fabPlane/viagrid_fp/ykush/README.md

# YKUSH-VG: 3-port switchable USB 2.0 hub on a Viagrid 9055 blank

A board that works like the [Yepkit YKUSH](https://www.yepkit.com/products/ykush), laid out for a
2-layer [Viagrid](https://github.com/opulo-inc/viagrid) 9055 blank.

- **Hub:** Terminus FE1.1s (SSOP-28). Upstream port is USB-C. Ports 1-3 go to the USB-A sockets,
  and port 4 goes to the control MCU.
- **Control:** WCH CH552G. The host sees it as a HID device. The plan is for its firmware to speak
  the YKUSH protocol, so `ykushcmd` works unchanged.
- **Port power:** one SY6280AAC current-limited switch per port. The CH552G drives each EN pin,
  and each EN has a 100k pull-down so the port stays off during boot.
- **Power:** from upstream VBUS, or from an external 5 V screw terminal. The two sources are
  diode-ORed onto `+5V_PORT`.

| File | What |
|---|---|
| `FEASIBILITY.md` | Why this is doable on Viagrid, and the risks |
| `kicad/ykush_vg.kicad_pro` / `.kicad_sch` | KiCad 10 project and schematic (generated) |
| `kicad/ykush_vg.kicad_sym`, `kicad/sym-lib-table` | Project symbol library (CH552G, SY6280AAC) |
| `kicad/ykush_vg_schematic.pdf` | PDF of the schematic |
| `kicad/bom.md`, `kicad/bom.csv` | BOM with Shopee/Lazada, AliExpress, DigiKey and JLCPCB columns |
| `kicad/nets.txt` | Netlist the generator intended |
| `tools/make_schematic.py` | **Source of truth.** Edit this, then regenerate |
| `tools/check_netlist.py` | Exports the netlist with kicad-cli and diffs it against `nets.txt` |
| `kicad/ykush_vg.kicad_pcb` | The PCB, generated by `tools/build_pcb.py` (see `pcb/LAYOUT.md`) |
| `firmware/` | CH552G firmware (SDCC), tests, host tool, udev rule |
| `fab/` | Laser DXFs, Gerbers, drill file, `holes_to_drill.csv`, placement file, previews |

```sh
cd tools && python3 make_schematic.py && python3 check_netlist.py
kicad-cli sch erc --severity-all ../kicad/ykush_vg.kicad_sch
```

Needs KiCad 10. The generator reads the KiCad 10 symbol libraries and then runs
`kicad-cli sch upgrade`, so the saved file is in KiCad's native format.

## Status
- [x] Schematic. Pinouts checked against the FE1.1s, CH552 and SY6280 datasheets, and against
  open-source boards.
- [x] BOM and sourcing
- [x] ERC in KiCad 10.0.6: 0 violations (all severities)
- [x] PCB layout on the Viagrid 9055 blank: fully routed. KiCad 10 DRC reports 0 errors,
  0 unconnected items and 0 schematic mismatches (details in `pcb/LAYOUT.md`).
- [x] Fabrication outputs in `fab/`: copper DXF for LightBurn, Gerbers, and the holes to drill
- [x] CH552 firmware (`firmware/`): YKUSH protocol with YKUSH USB IDs, so `ykushcmd` works.
  It builds to about 2.5 KB and passes descriptor, unit and `ykushcmd` end-to-end tests. It has not
  yet run on real hardware.
- [ ] Build and test a real board

## CH552G pin map (for the firmware)

| Function | CH552G pin |
|---|---|
| USB D+ / D- (hub port 4, Full-Speed) | P3.6 / P3.7 |
| EN port 1 (J2, left) | P1.4 |
| EN port 2 (J3, middle) | P3.3 |
| EN port 3 (J4, right) | P3.4 |
| Status LED (active high) | P3.2 |
| BOOT button (UDP pull-up at power-on) | P3.6 via 10k |

The EN pins are active high. Each has a 100k pull-down, so the ports stay off until the
firmware drives them.
