fabPlane/viagrid_fp/ykush/fab/preview_bottom.png

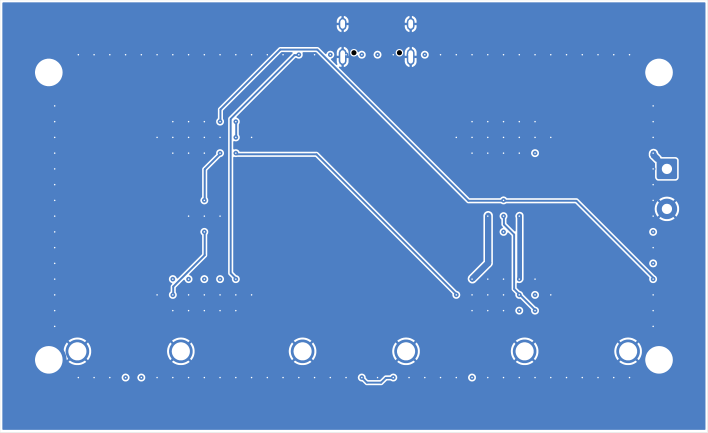
ykush/fab/preview_bottom.png
