fabPlane/viagrid_fp/ykush/fab/preview_top.png

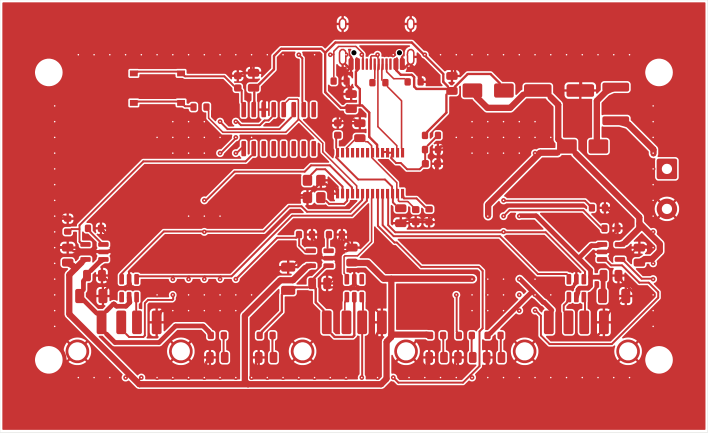
ykush/fab/preview_top.png
