fabPlane/viagrid_fp/ykush/kicad/bom.md

# YKUSH-VG bill of materials

Generated by `tools/make_schematic.py` + `tools/bom.py`. Sourcing checked 2026-09-24 from search listings; confirm price and stock before ordering.

- **25 BOM lines**, 62 parts in total.
- **Shopee/Lazada Thailand:** 18 lines seen listed, 1 likely (commodity, no exact listing seen), 6 not found in Thailand (AliExpress/LCSC instead). Many IC listings are cross-border sellers: allow 1-2 weeks.
- **JLCPCB:** 14 lines are Basic parts, 9 are Extended (about $3 setup fee each for assembly).
- **DigiKey:** does not carry the Chinese ICs (FE1.1s, CH552G, SY6280AAC); alternatives are listed but change the circuit.

| # | Refs | Qty | Part | Footprint | Shopee / Lazada (Thailand) | AliExpress | DigiKey | JLCPCB (LCSC #) | JLC type | Notes |
|---|---|---|---|---|---|---|---|---|---|---|
| 1 | U1 | 1 | Terminus FE1.1S-BSOP28 (USB 2.0 HS 4-port hub) | SSOP-28_3.9x9.9mm_P0.635mm | YES - Shopee TH (5 pcs) | YES | NO (alt: Microchip USB2514B-AEZC-TR, QFN-36) | C9359 | Extended | Buy genuine Rev B (FE1.1S-BSOP28). Cross-border seller: 1-2 weeks. |
| 2 | U2 | 1 | WCH CH552G (SOP-16 MCU, USB device) | SOIC-16_3.9x9.9mm_P1.27mm | YES - Shopee TH (variant in WCH multi-chip listing) | YES | NO (alt: PIC16F1455-I/SL; needs different firmware) | C111292 | Extended | Blank chips boot into the USB bootloader. |
| 3 | U3 U5 U7 | 3 | Silergy SY6280AAC load switch | SOT-23-5 | NO (MT9700 is on Shopee TH; verify pinout before substituting) | YES | NO (alt: TI TPS2051BDBVR, different pinout) | C55136 | Extended | Order from AliExpress/LCSC. Not SY6280AAAC (C207620). |
| 4 | U4 U6 U8 | 3 | ST USBLC6-2SC6 USB ESD array | SOT-23-6 | YES - Shopee TH, Lazada TH | YES | 497-5235-1-ND | C7519 | Extended |  |
| 5 | Y1 | 1 | YXC X322512MSB4SI 12 MHz 3225 4-pad | Crystal_SMD_3225-4Pin_3.2x2.5mm | NO (only HC-49 seen) | YES | Abracon ABM8-12.000MHZ-B2-T (535-9826-1-ND) | C9002 | Basic | Passive crystal, not an oscillator. FE1.1s has internal load caps. |
| 6 | J1 | 1 | HRO TYPE-C-31-M-12 (USB 2.0 16-pin) | USB_C_Receptacle_HRO_TYPE-C-31-M-12 | YES - Shopee TH (TYPE-C-31-M-12), Lazada TH (16P) | YES | NO (alt: GCT USB4105-GF-A, 2073-USB4105-GF-ACT-ND) | C165948 | Extended | Shell pegs need drilled holes on a Viagrid. |
| 7 | J2 J3 J4 | 3 | TE 292303-7 USB-A receptacle, right angle, SMT signal pins | USB_A_TE_292303-7_Horizontal | NO (TH has generic THT 4-pin 90deg; different footprint) | LIKELY | TE 292303-7 | (search LCSC) | Extended | SMT signal pads keep the Viagrid build simple; only the 2 shell tabs need holes. |
| 8 | J5 | 1 | Screw terminal 2P 5.08 mm (KF301-2P) | TerminalBlock_Phoenix_MKDS-1,5-2-5.08_1x02_P5.08mm_Horizontal | YES - Shopee TH, Lazada TH, Cybertice, MyArduino | YES | Phoenix 1935161 (277-1667-ND) | C474881 | Extended | THT: drill 2 holes, solder from the bottom. |
| 9 | SW1 | 1 | Tactile switch 5.1x5.1 mm SMD (XKB TS-1187A-B-A-B) | SW_Push_1P1T_XKB_TS-1187A | NO (only 3x4 / 4.5x4.5 / 6x6 seen) | YES | C&K PTS810 SJM 250 SMTR LFS | C318884 | Basic | Hold while plugging in = CH552 bootloader. |
| 10 | F1 | 1 | PTC resettable fuse 1812, 2 A hold | Fuse_1812_4532Metric | YES - Shopee TH (PPTC kit incl. 1812) | YES | Littelfuse 1812L200/12DR | C315901 | Extended |  |
| 11 | D1 D2 | 2 | SS34 Schottky 3 A 40 V, SMA | D_SMA | YES - Shopee TH (ships from Thailand) | YES | Vishay SSA34-E3/61T | C8678 | Basic |  |
| 12 | D3 D4 D5 D6 D7 | 5 | LED green 0805 | LED_0805_2012Metric | YES - Shopee TH, Lazada TH (0805 colour kits) | YES | Lite-On LTST-C171GKT | C2297 | Basic |  |
| 13 | C1 C3 C4 C6 C9 C11 C13 C14 C16 C17 C19 | 11 | MLCC 10 uF 25 V X5R 0805 | C_0805_2012Metric | YES - Lazada TH (0805 kit) | YES | Samsung CL21A106KAYNNNC | C15850 | Basic |  |
| 14 | C2 | 1 | Alu electrolytic 220 uF 10 V SMD 6.3x7.7 mm | CP_Elec_6.3x7.7 | YES - Shopee TH (220u/16V 6.3x7.7), Lazada TH | YES | Panasonic EEE-FK1A221P (verify) | (pick on LCSC) | Extended | Bulk on +5V_PORT. |
| 15 | C5 C7 C8 C10 | 4 | MLCC 100 nF 50 V X7R 0603 | C_0603_1608Metric | YES - Shopee TH (0603 kit) | YES | Yageo CC0603KRX7R9BB104 | C14663 | Basic |  |
| 16 | C12 C15 C18 | 3 | MLCC 22 uF 25 V X5R 1206 | C_1206_3216Metric | LIKELY | YES | Samsung CL31A226KAHNNNE | C12891 | Basic | Per-port bulk. USB 2.0 asks for 120 uF per port; SY6280 soft-start limits inrush instead. |
| 17 | R1 R2 | 2 | Resistor 5.1 k 1% 0603 | R_0603_1608Metric | YES - Shopee TH (0603 kit, 33 values x 20) | YES | generic | C23186 | Basic | USB-C CC |
| 18 | R3 R8 R11 R14 R17 | 5 | Resistor 1 k 1% 0603 | R_0603_1608Metric | YES - Shopee TH (0603 kit, 33 values x 20) | YES | generic | C21190 | Basic |  |
| 19 | R4 | 1 | Resistor 2.7 k 1% 0603 (FE1.1s REXT) | R_0603_1608Metric | YES - Shopee TH (0603 kit, 33 values x 20) | YES | generic | C13167 | Basic | Must be 1%. |
| 20 | R5 | 1 | Resistor 56 k 1% 0603 | R_0603_1608Metric | YES - Shopee TH (0603 kit, 33 values x 20) | YES | generic | C23206 | Basic | VBUSM divider top (also drives XRSTJ/BUSJ). |
| 21 | R6 R10 R13 R16 | 4 | Resistor 100 k 1% 0603 | R_0603_1608Metric | YES - Shopee TH (0603 kit, 33 values x 20) | YES | generic | C25803 | Basic |  |
| 22 | R7 R9 R12 R15 | 4 | Resistor 10 k 1% 0603 | R_0603_1608Metric | YES - Shopee TH (0603 kit, 33 values x 20) | YES | generic | C25804 | Basic | ISET: 10k = ~0.68 A limit; 6.8k (C23212) = ~1 A. |
| 23 | JP1 | 1 | Resistor 0 R 0603 (jumper over USB-C D+ trace) | R_0603_1608Metric | YES - Shopee TH (0603 kit, 33 values x 20) | YES | generic | C21189 | Basic | Board jumper: USB-C data pads are interleaved. |
| 24 | - | 1 | Viagrid 9055 Standard blank (90x55 mm, 2-layer, ENIG) | - | NO | NO | NO | - | - | Opulo (opulo.io), or have JLCPCB/PCBWay make it from the open-source Viagrid files. |
| 25 | - | 1 | Enclosure Hammond 1591XXB (optional) | - | NO (generic ABS boxes only) | LIKELY (clones) | HM1038-ND (1591XXBBK) | - | - | TME Thailand lists Hammond (ships from abroad). |
