fabPlane/viagrid_fp/ykush/fab/copper_top.dxf

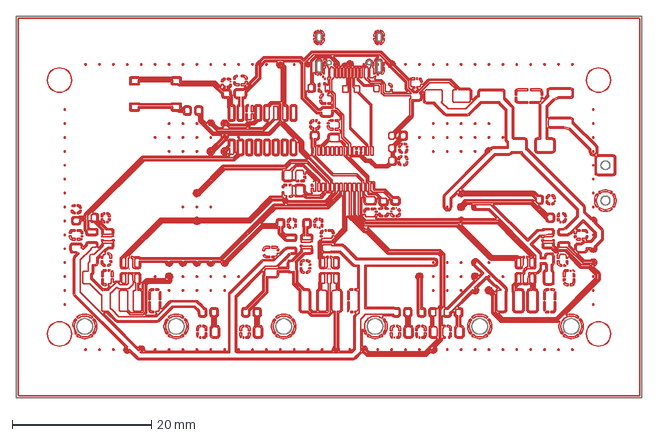
[picture p3: CAD file, 2026-09-24]
ykush/fab/copper_top.dxf
89.9 x 54.9 mm
