fabPlane/viagrid_fp/ykush/fab/copper_bottom.dxf

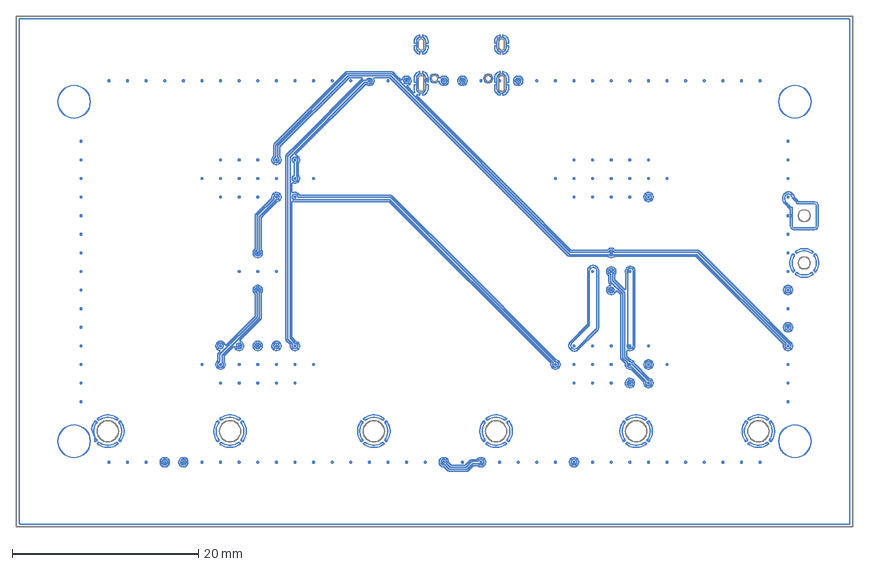
[picture p4: CAD file, 2026-09-24]
ykush/fab/copper_bottom.dxf
89.9 x 54.9 mm
