fabPlane/viagrid_fp/ykush/kicad/ykush_vg_schematic.pdf

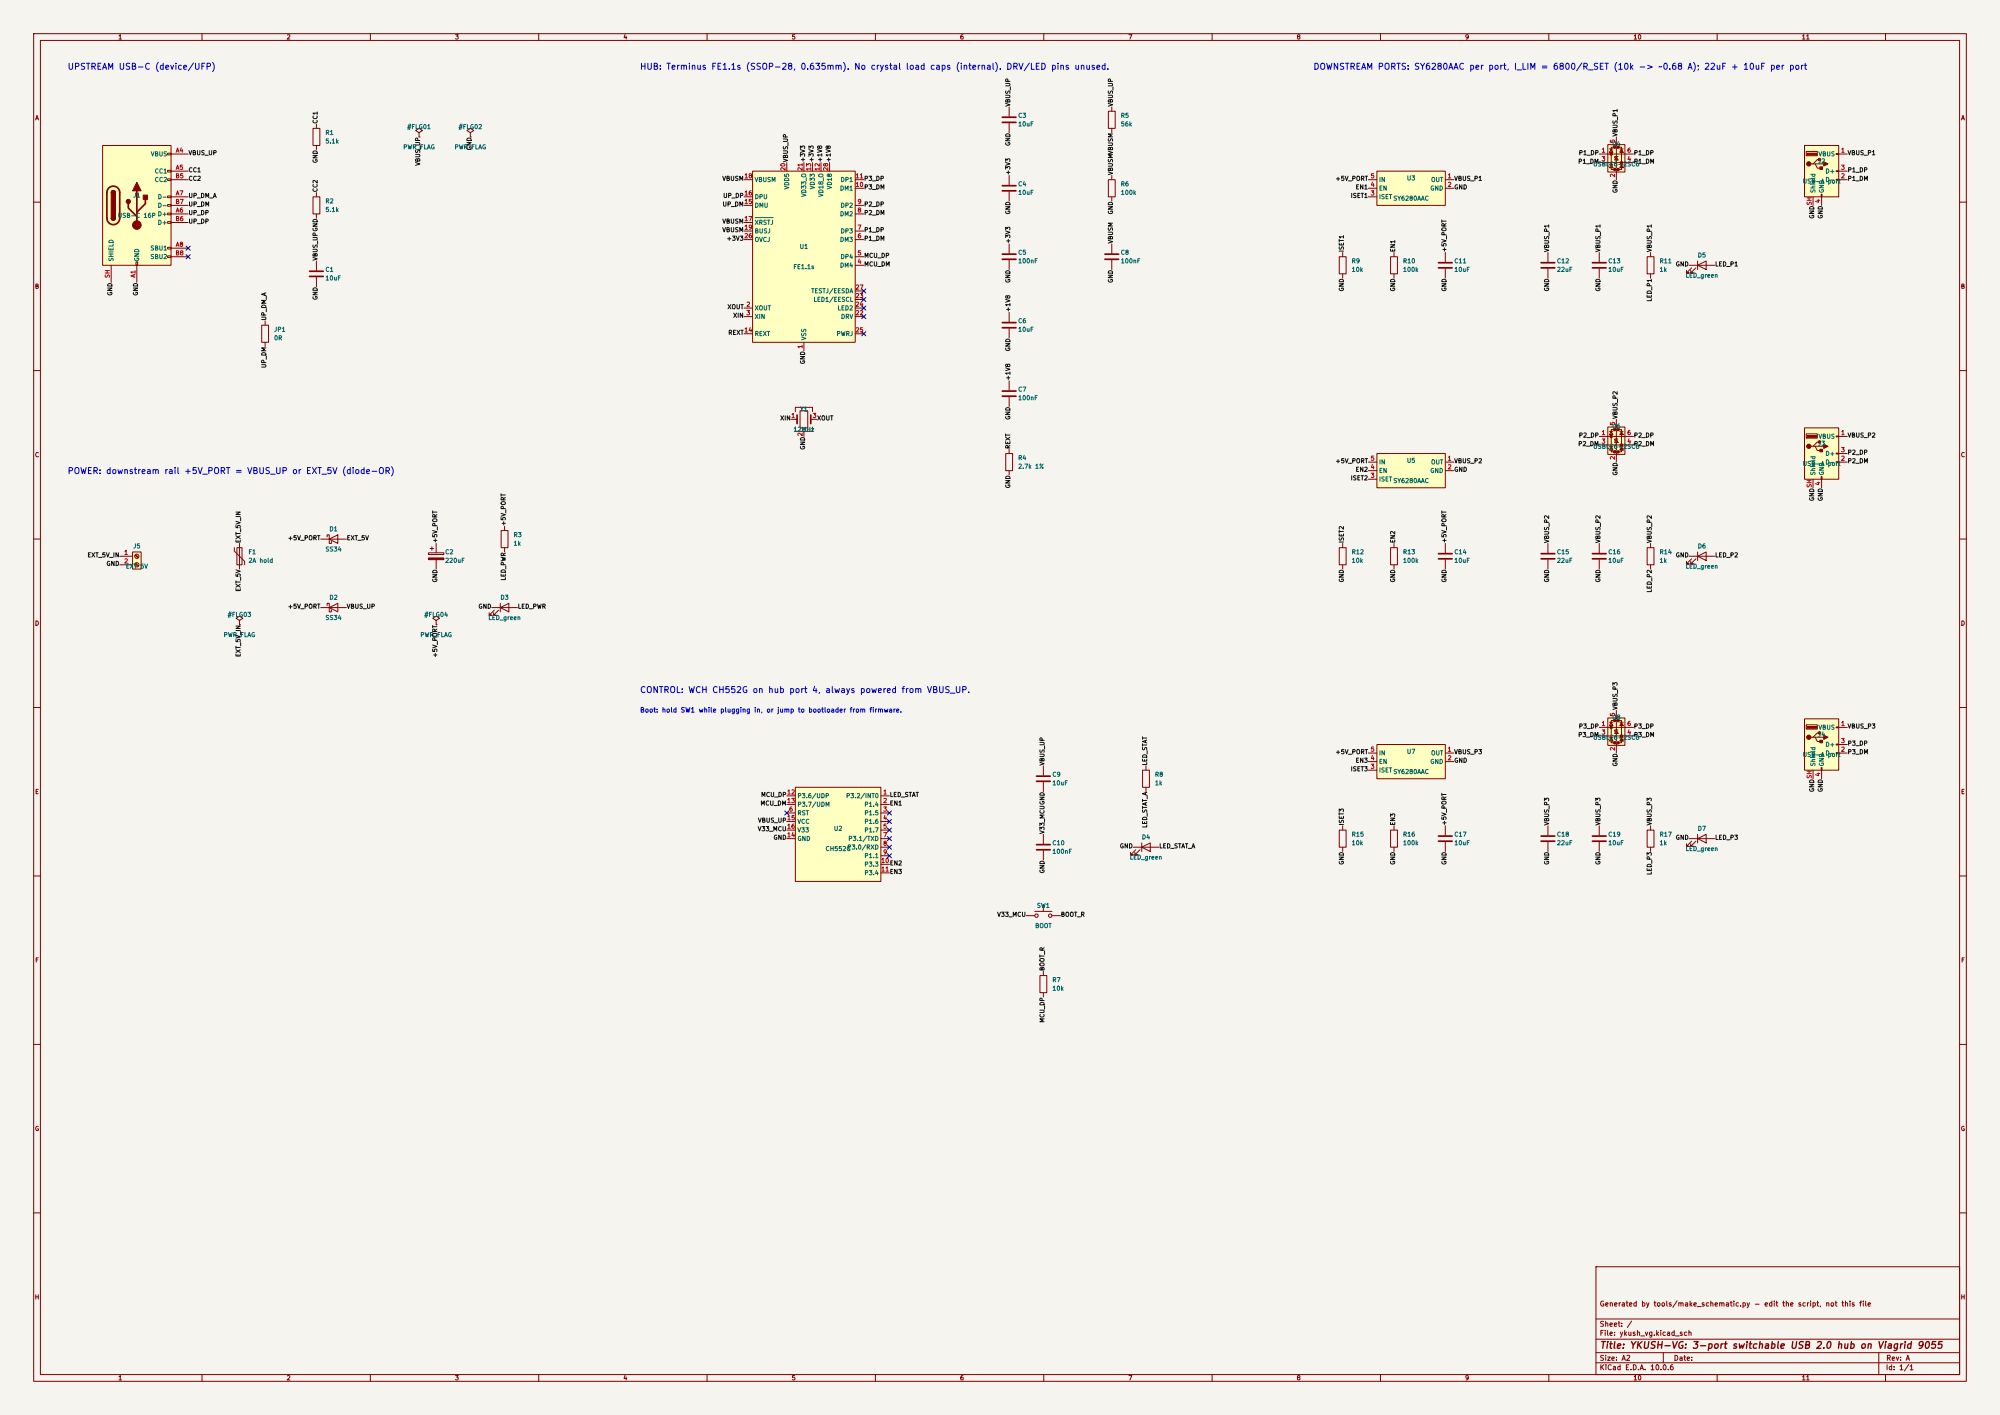
[picture p5: page 1]

HUB: Terminus FE1.1s (SSOP-28, 0.635mm). No crystal load caps (internal). DRV/LED pins unused.
TESTJ/EESDA 27 VD18 28 U1

POWER: downstream rail +5V_PORT = VBUS_UP or EXT_5V (diode-OR)

Boot: hold SW1 while plugging in, or jump to bootloader from firmware. CONTROL: WCH CH552G on hub port 4, always powered from VBUS_UP.

Generated by tools/make_schematic.py - edit the script, not this file

Sheet: /
File: ykush_vg.kicad_sch
Title: YKUSH-VG: 3-port switchable USB 2.0 hub on Viagrid 9055

Size: A2 | Rev: A
KiCad E.D.A. 10.0.6 | Id: 1/1
