fabPlane/viagrid_fp/ykush/kicad/ykush_vg.kicad_pcb

## KiCad design ykush/kicad/ykush_vg.kicad_pcb (2026-09-24)

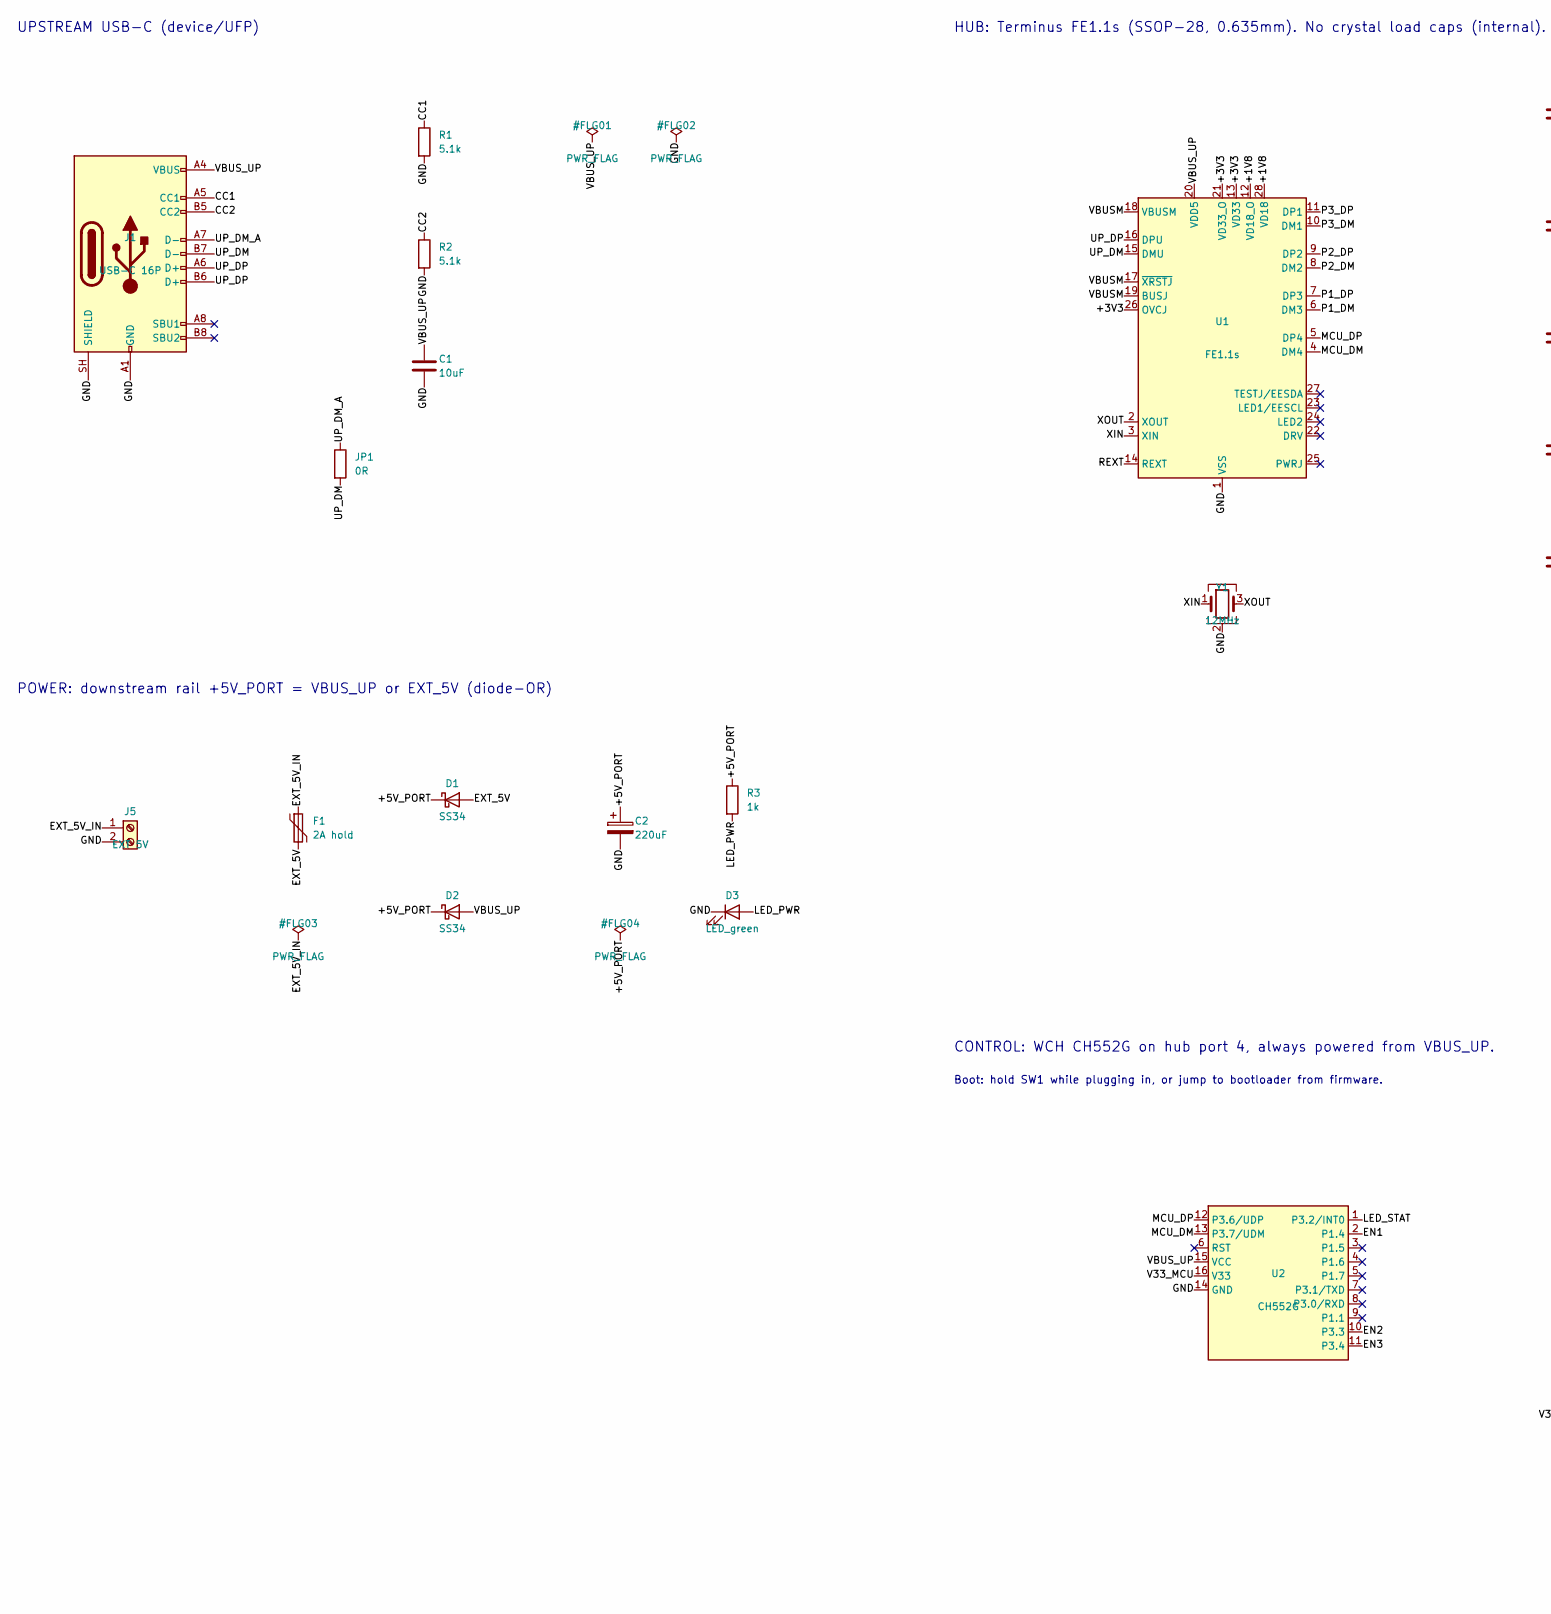
[picture p6: schematic ykush_vg.kicad_sch, YKUSH-VG: 3-port switchable USB 2.0 hub on Viagrid 9055, part in row 1, column 1]

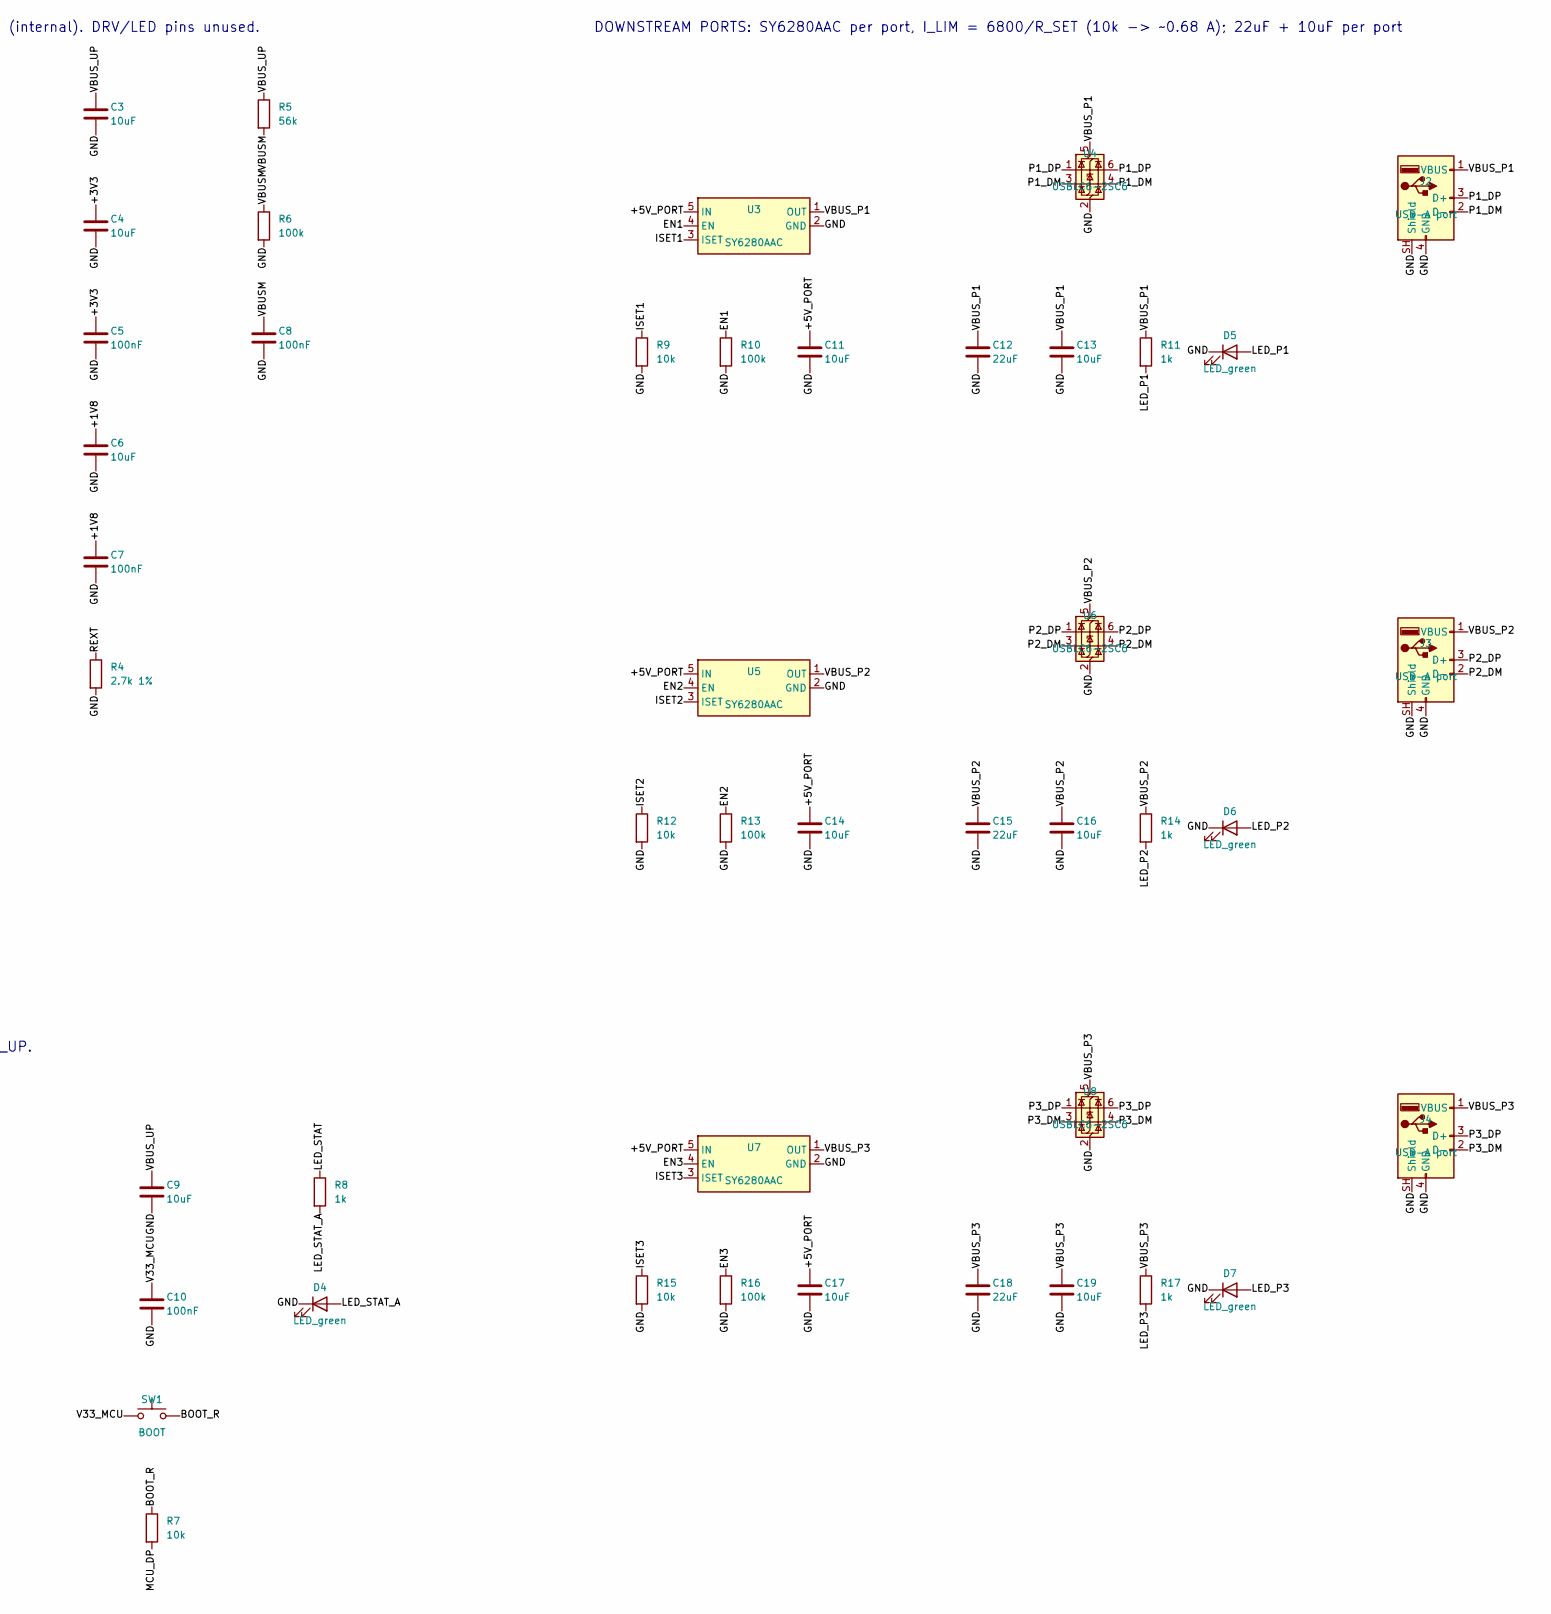
[picture p7: schematic ykush_vg.kicad_sch, YKUSH-VG: 3-port switchable USB 2.0 hub on Viagrid 9055, part in row 1, column 2]

Parts:
C1, C3, C4, C6, C9, C11, C13, C14, C16, C17, C19: 10uF; C_0805_2012Metric
C2: 220uF; CP_Elec_6.3x7.7
C5, C7, C8, C10: 100nF; C_0603_1608Metric
C12, C15, C18: 22uF; C_1206_3216Metric
D1, D2: SS34; D_SMA
D3, D4, D5, D6, D7: LED_green; LED_0805_2012Metric
F1: 2A hold; Fuse_1812_4532Metric
J1: USB-C 16P; USB_C_Receptacle_HRO_TYPE-C-31-M-12
J2, J3, J4: USB-A port; USB_A_TE_292303-7_Horizontal
J5: EXT 5V; TerminalBlock_Phoenix_MKDS-1,5-2-5.08_1x02_P5.08mm_Horizont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
JP1: 0R; R_0603_1608Metric
R1, R2: 5.1k; R_0603_1608Metric
R3, R8, R11, R14, R17: 1k; R_0603_1608Metric
R4: 2.7k 1%; R_0603_1608Metric
R5: 56k; R_0603_1608Metric
R6, R10, R13, R16: 100k; R_0603_1608Metric
R7, R9, R12, R15: 10k; R_0603_1608Metric
SW1: BOOT; SW_Push_1P1T_XKB_TS-1187A
U1: FE1.1s; SSOP-28_3.9x9.9mm_P0.635mm
U2: CH552G; SOIC-16_3.9x9.9mm_P1.27mm
U3, U5, U7: SY6280AAC; SOT-23-5
U4, U6, U8: USBLC6-2SC6; SOT-23-6
Y1: 12MHz; Crystal_SMD_3225-4Pin_3.2x2.5mm

Connections:
/+1V8: C6.1, C7.1, U1.12 (VD18_O), U1.28 (VD18)
/+3V3: C4.1, C5.1, U1.13 (VD33), U1.21 (VD33_O), U1.26 (OVCJ)
/+5V_PORT: C2.1, C11.1, C14.1, C17.1, D1.1 (K), D2.1 (K), R3.1, U3.5 (IN), U5.5 (IN), U7.5 (IN)
/BOOT_R: R7.1, SW1.2
/CC1: J1.A5 (CC1), R1.1
/CC2: J1.B5 (CC2), R2.1
/EN1: R10.1, U2.2 (P1.4), U3.4 (EN)
/EN2: R13.1, U2.10 (P3.3), U5.4 (EN)
/EN3: R16.1, U2.11 (P3.4), U7.4 (EN)
/EXT_5V: D1.2 (A), F1.2
/EXT_5V_IN: F1.1, J5.1
/GND: C1.2, C2.2, C3.2, C4.2, C5.2, C6.2, C7.2, C8.2, C9.2, C10.2, C11.2, C12.2, C13.2, C14.2, C15.2, C16.2, C17.2, C18.2, C19.2, D3.1 (K), D4.1 (K), D5.1 (K), D6.1 (K), D7.1 (K), J1.A1 (GND), J1.A12 (GND), J1.B1 (GND), J1.B12 (GND), J1.SH (SHIELD), J2.4 (GND), J2.SH (Shield), J3.4 (GND), J3.SH (Shield), J4.4 (GND), J4.SH (Shield), J5.2, R1.2, R2.2, R4.2, R6.2, R9.2, R10.2, R12.2, R13.2, R15.2, R16.2, U1.1 (VSS), U2.14 (GND), U3.2 (GND), U4.2 (GND), U5.2 (GND), U6.2 (GND), U7.2 (GND), U8.2 (GND), Y1.2 (G), Y1.4 (G)
/ISET1: R9.1, U3.3 (ISET)
/ISET2: R12.1, U5.3 (ISET)
/ISET3: R15.1, U7.3 (ISET)
/LED_P1: D5.2 (A), R11.2
/LED_P2: D6.2 (A), R14.2
/LED_P3: D7.2 (A), R17.2
/LED_PWR: D3.2 (A), R3.2
/LED_STAT: R8.1, U2.1 (P3.2/INT0)
/LED_STAT_A: D4.2 (A), R8.2
/MCU_DM: U1.4 (DM4), U2.13 (P3.7/UDM)
/MCU_DP: R7.2, U1.5 (DP4), U2.12 (P3.6/UDP)
/P1_DM: J2.2 (D-), U1.6 (DM3), U4.3 (I/O2), U4.4 (I/O2)
/P1_DP: J2.3 (D+), U1.7 (DP3), U4.1 (I/O1), U4.6 (I/O1)
/P2_DM: J3.2 (D-), U1.8 (DM2), U6.3 (I/O2), U6.4 (I/O2)
/P2_DP: J3.3 (D+), U1.9 (DP2), U6.1 (I/O1), U6.6 (I/O1)
/P3_DM: J4.2 (D-), U1.10 (DM1), U8.3 (I/O2), U8.4 (I/O2)
/P3_DP: J4.3 (D+), U1.11 (DP1), U8.1 (I/O1), U8.6 (I/O1)
/REXT: R4.1, U1.14 (REXT)
/UP_DM: J1.B7 (D-), JP1.2, U1.15 (DMU)
/UP_DM_A: J1.A7 (D-), JP1.1
/UP_DP: J1.A6 (D+), J1.B6 (D+), U1.16 (DPU)
/V33_MCU: C10.1, SW1.1, U2.16 (V33)
/VBUSM: C8.1, R5.2, R6.1, U1.17 (~XRSTJ), U1.18 (VBUSM), U1.19 (BUSJ)
/VBUS_P1: C12.1, C13.1, J2.1 (VBUS), R11.1, U3.1 (OUT), U4.5 (VBUS)
/VBUS_P2: C15.1, C16.1, J3.1 (VBUS), R14.1, U5.1 (OUT), U6.5 (VBUS)
/VBUS_P3: C18.1, C19.1, J4.1 (VBUS), R17.1, U7.1 (OUT), U8.5 (VBUS)
/VBUS_UP: C1.1, C3.1, C9.1, D2.2 (A), J1.A4 (VBUS), J1.A9 (VBUS), J1.B4 (VBUS), J1.B9 (VBUS), R5.1, U1.20 (VDD5), U2.15 (VCC)
/XIN: U1.3 (XIN), Y1.1
/XOUT: U1.2 (XOUT), Y1.3

Notes on the sheet:
HUB: Terminus FE1.1s (SSOP-28, 0.635mm). No crystal load caps (internal). DRV/LED pins unused.
UPSTREAM USB-C (device/UFP)
POWER: downstream rail +5V_PORT = VBUS_UP or EXT_5V (diode-OR)
DOWNSTREAM PORTS: SY6280AAC per port, I_LIM = 6800/R_SET (10k -> ~0.68 A); 22uF + 10uF per port
Boot: hold SW1 while plugging in, or jump to bootloader from firmware.
CONTROL: WCH CH552G on hub port 4, always powered from VBUS_UP.

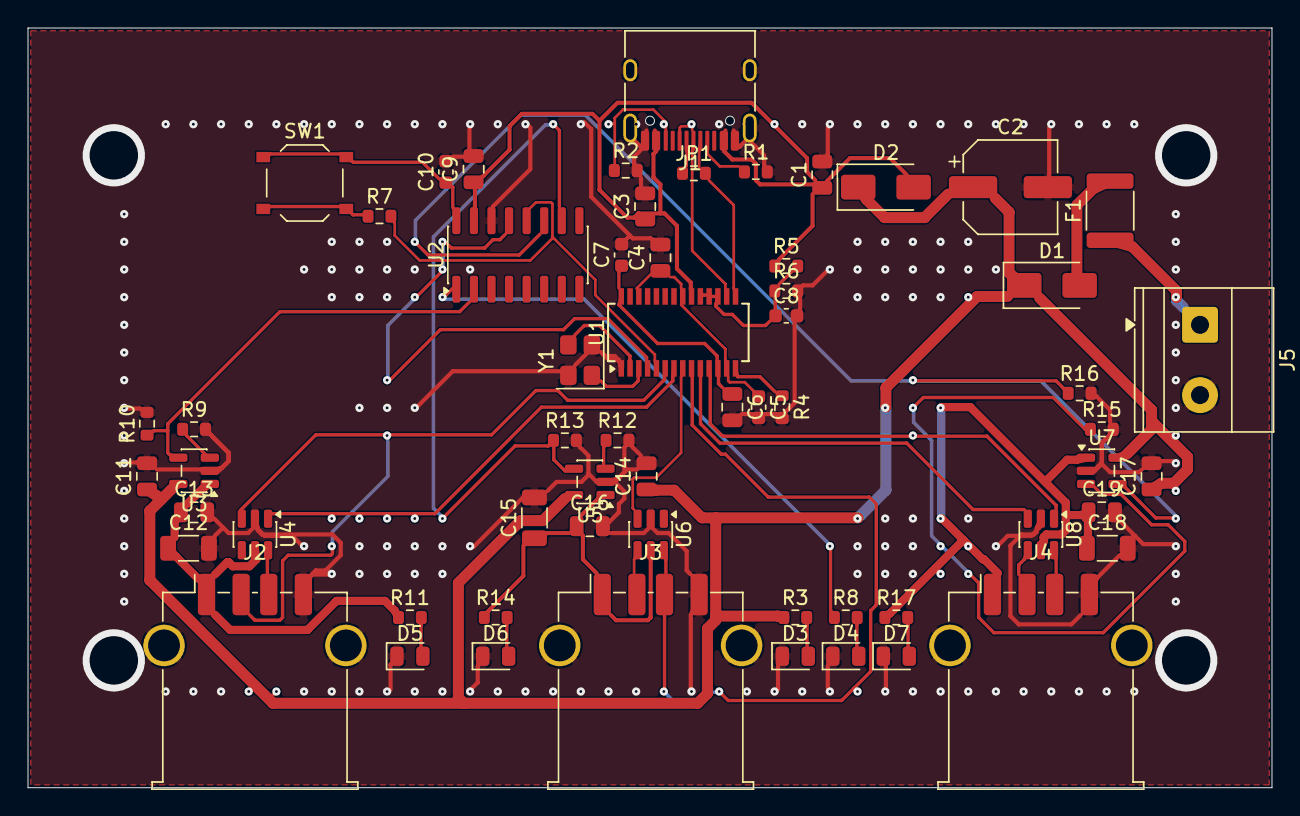
[picture p8: board ykush_vg.kicad_pcb from above]

Board: 2 copper layers, 89.9 x 54.9 mm, 60 parts (0 on the bottom side), 41 nets.
