fabPlane/viagrid_fp/(commit log)

2026-09-24 WIP: schematic generator tooling for YKUSH-VG
    Claude-Session: https://claude.ai/code/session_01EEWbo5vCC8AQXSYmE1aT85
2026-09-24 YKUSH-VG schematic: FE1.1s hub + CH552G control + 3x SY6280 port switches
    Schematic is generated by tools/make_schematic.py (label-per-pin, KiCad 7
    format so it opens in KiCad 7-10). Pinouts verified against datasheets and
    cross-checked with open-source boards; KiCad netlist export matches the
    intended nets exactly.
    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
    [ykush_vg.kicad_sch]
2026-09-24 YKUSH-VG: BOM with Shopee/Lazada, AliExpress, DigiKey and JLCPCB sourcing
    - bom.md / bom.csv generated from the schematic, with sourcing per line
    - LEDs moved to 0805 green (JLC Basic C2297); bulk caps 220uF
    - debug header J6 marked DNP
    - check_netlist.py verifies KiCad's netlist against the intended nets
    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
    [bom.csv, ykush_vg.kicad_sch]
2026-09-24 YKUSH-VG: move to KiCad 10.0.6, ERC clean
    - symbols now come from the KiCad 10 libraries (symdir format), and
    kicad-cli sch upgrade re-saves the schematic in native v10 format
    - project file, project symbol library (CH552G, SY6280AAC) and sym-lib-table
    - placements snapped to the 2.54 mm grid; USB shield pins renamed to SH (v10)
    - screw terminal footprint -> Phoenix MKDS 5.08 (bornier removed in v10)
    - kicad-cli sch erc --severity-all: 0 violations; netlist check: 50/50 nets
    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
    [bom.csv, ykush_vg.kicad_sch]
2026-09-24 YKUSH-VG: layout tooling, Viagrid-aware router, schematic changes for layout, Thailand BOM
    - build_pcb.py / placement.py / router.py: build the board with KiCad 10's pcbnew API;
    grid A* router (C core) that only changes layer at the blank's pre-made vias,
    with negotiated-congestion (PathFinder) iterations
    - viagrid_9055.json: via map extracted from the official template (it is a ring plus
    clusters, not a full grid); LAYOUT.md documents the constraints and decisions
    - schematic: hub port order matched to the board, 0R jumper for the USB-C D+ pads,
    TE 292303-7 SMT USB-A, 22uF per-port bulk, debug header and hub LED dropped,
    XRSTJ/BUSJ tied to the VBUSM divider
    - BOM: Shopee/Lazada co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
    [bom.csv, ykush_vg.kicad_sch]
2026-09-24 WIP: DRC helper, project file, work-in-progress board (routing not finished)
    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
    [ykush_vg.kicad_pcb]
2026-09-24 YKUSH-VG: rework USB-C entry (JP1 on D-, VBUS via B.Cu spine, drop upstream ESD), move hub decoupling
    Board file is still work in progress (routing run in progress).
    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
    [bom.csv, ykush_vg.kicad_pcb, ykush_vg.kicad_sch]
2026-09-24 YKUSH-VG: rotate port ESDs so D-/D+ line up with the USB-A pins
    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
    [ykush_vg.kicad_pcb]
2026-09-24 YKUSH-VG: keep KiCad net names, GND stub pass, DRC helper fixes, silk checks off (no silkscreen on Viagrid)
    Board file still in progress.
    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
    [ykush_vg.kicad_pcb]
2026-09-24 Router: tie proximity-claimed vias with a stub; GND stitching to main pour and islands; hole clearance rule for drilled pegs
    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
2026-09-24 build_pcb: run the GND connectivity check on a temp copy
    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
2026-09-24 WIP board snapshot (routing run in progress)
    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
    [ykush_vg.kicad_pcb]
2026-09-24 Router: KiCad jumper pad groups for flow-through ESDs, early GND ties for walled-in GND pins, stitch-only mode
    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
2026-09-24 WIP board snapshot (reroute in progress)
    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
    [ykush_vg.kicad_pcb]
2026-09-24 Router: exact-width diagonal rasterisation, tunable negotiation params, ESD GND ties; parallel sweep driver
    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
2026-09-24 WIP board snapshot
    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
    [ykush_vg.kicad_pcb]
2026-09-24 Router: tie jumper-group paths to the pad they start in; GND tie vias on /GND; slow nets may use B.Cu freely
    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
2026-09-24 Route GND as a net (pads to nearest Viagrid via); finish pass (retry unrouted nets, sync pin changes); EN1 moved to CH552 P1.4; geometric pour-island detection
    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
    [ykush_vg.kicad_pcb, ykush_vg.kicad_sch]
2026-09-24 YKUSH-VG board checkpoint: all nets routed except EN2, 0 DRC errors
    Routing: GND routed as a net, EN lines prioritised in the next sweep.
    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
    [ykush_vg.kicad_pcb, ykush_vg.kicad_sch]
2026-09-24 Port 2: ISET/EN resistors next to their SY6280 pins; EN lines routed earlier
    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
    [ykush_vg.kicad_pcb]
2026-09-24 YKUSH-VG: fully routed PCB on Viagrid 9055 (DRC: 0 errors, 0 unconnected, 0 parity) + fab outputs
    - kicad/ykush_vg.kicad_pcb: best of a 4-variant routing sweep, all 41 nets routed
    - fab/: copper DXFs for LightBurn, Gerbers + drill, holes_to_drill.csv (14 holes),
    positions.csv, top/bottom previews
    - README: status, CH552G pin map for the firmware; LAYOUT.md: results and router notes
    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
    [copper_bottom.dxf, copper_top.dxf, holes_to_drill.csv, positions.csv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]
2026-09-24 YKUSH-VG firmware: CH552G YKUSH-protocol HID firmware, tests, host tool
    - SDCC firmware for the CH552G on hub port 4: HID device 04D8:F2F7 speaking
    the Yepkit YKUSH protocol (port on/off/status, all-ports, bootloader jump)
    - Board support for EN1-3 (P1.4/P3.3/P3.4) and status LED (P3.2)
    - Tests: protocol unit tests, descriptor check against the built image,
    and an end-to-end run of the upstream ykushcmd against a mocked HID layer
    - Host: ykvg.py (hidapi CLI) and a udev rule
    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
